mcer12/Nick-ESP8266/Media/truth_table_74141.jpg

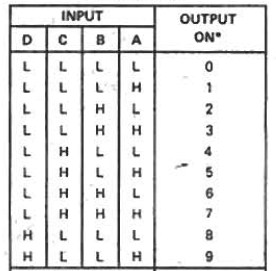
Media/truth_table_74141.jpg
