mcer12/Nick-ESP8266/Schematics + BOM/Schematic_NICK-IN16_DUPLEXED.png

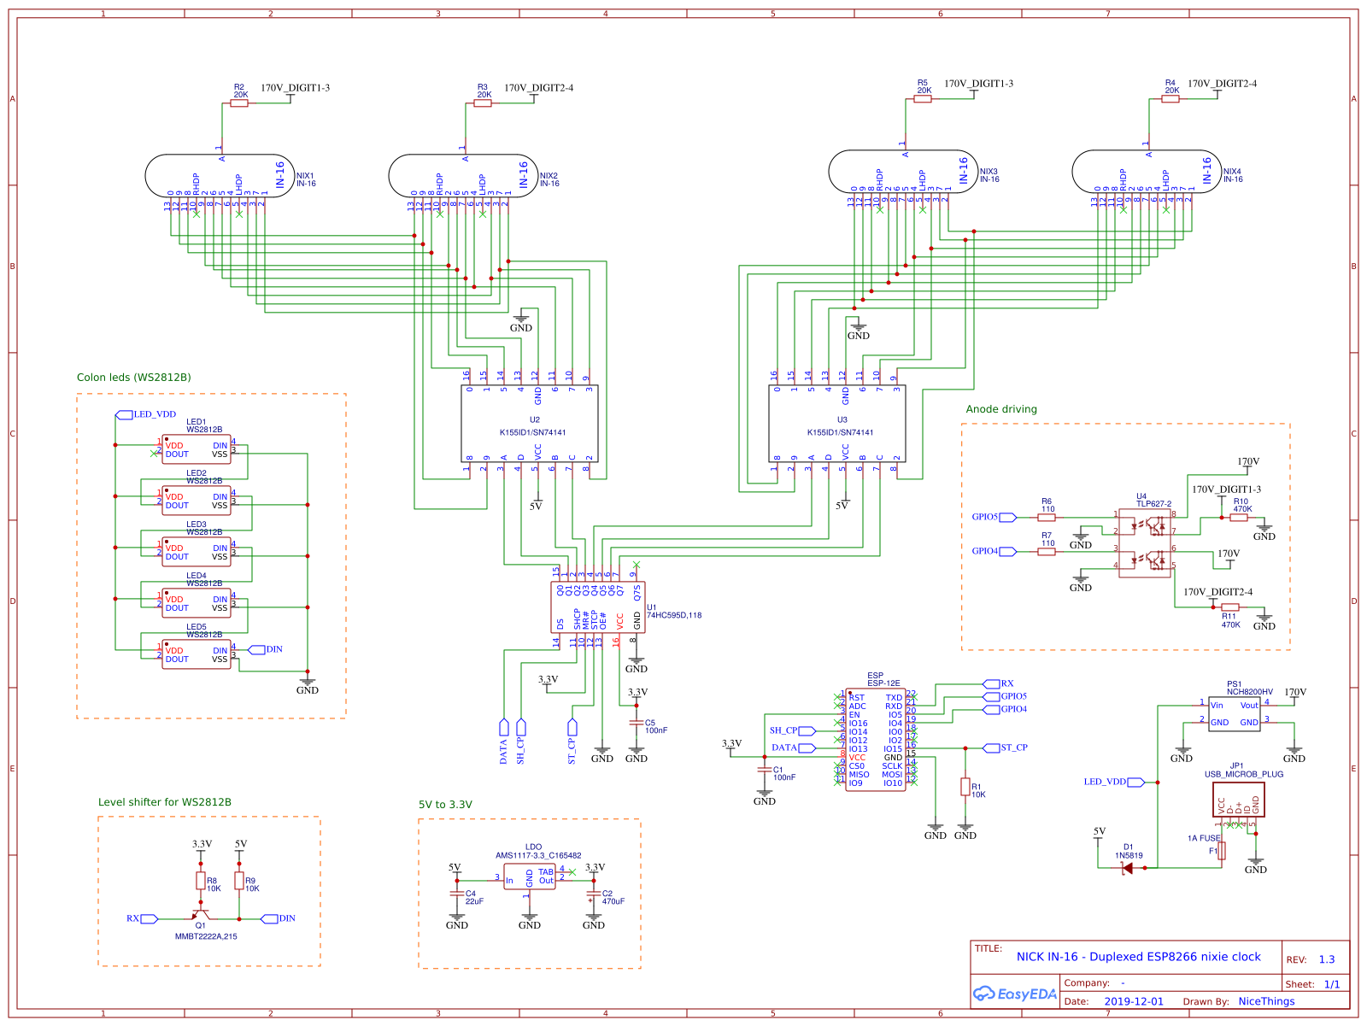
Schematics + BOM/Schematic_NICK-IN16_DUPLEXED.png
