mcer12/Nick-ESP8266/Schematics + BOM/NICK-IN12_BOM.csv

ID | Name | Designator | Footprint | Quantity | Manufacturer Part | Manufacturer | Supplier | Supplier Part | LCSC Assembly
1 | 10uF | C3 | CAP_0603 | 1 | TCC0603X5R106M160CT | CCTC | LCSC | C380317
2 | 330 | R6,R7 | R0603 | 2 | 0603WAJ0331T5E | UniOhm | LCSC | C25231
3 | K155ID1/SN74141 | U3,U4,U5,U6 | DIP16 | 4
4 | TLP627-2(F) | U8 | PDIP-8_L9.5-W6.6-P2.54-LS8.0-BL | 1 | TLP627-2(F) | TOSHIBA | LCSC | C845530
5 | MMBT2222A,215 | Q1 | SOT-23-3_L2.9-W1.6-P1.90-LS2.8-BR | 1 | MMBT2222A,215 | Nexperia | LCSC | C179396 | Yes
6 | 74HC595D,118 | U1,U2 | SOIC-16_150MIL | 2 | 74HC595D,118 | Nexperia | LCSC | C5947 | Yes
7 | U-D-M5DD-W-1 | USB1 | MICRO-USB-TH_MICRO-USB-A14 | 1 | U-D-M5DD-W-1 | HRO | LCSC | C145795
8 | 1A FUSE | F1 | FUSE_0805 | 1 | SMD0805P110TF | Yenji Elec | LCSC | C393933
9 | 100nF | C1,C4,C5 | 0603 | 3 | C0603C104K5RACTU | KEMET | LCSC | C127833
10 | WS2812B | LED1,LED2,LED3,LED4,LED5 | LED-5050_4P | 5 | WS2812B | Worldsemi | LCSC | C114585
11 | NCH8200HV | PS1 | NCH8200HV-1 | 1 | NCH8200HV
12 | 10K | R1,R8,R9 | RES_0603 | 3 | PTFR0603D10K0P9 | ResistorToday | LCSC | C375971
13 | 20K | R2,R3,R4,R5 | 1210 | 4 | RC1210JR-0720KL | YAGEO | LCSC | C276323
14 | AMS1117-3.3_C351784 | U7 | SOT-223-3_L6.5-W3.4-P2.30-LS7.0-BR | 1 | AMS1117-3.3 | PUOLOP | LCSC | C351784
15 | 470uF | C2 | CASE-D_7343 | 1 | TAJD477M006RNJ | AVX | LCSC | C106188 | Yes
16 | SW_IN-12B | NIX1,NIX2,NIX3,NIX4 | PK_IN-12B | 4
17 | 1N5819 | D1 | SOD-323_L1.8-W1.3-LS2.5-RD | 1 | 1N5819WS | KEXIN | LCSC | C369937
18 | ESP-12E | ESP | WIFIM-SMD_ESP-12E | 1 | ESP-12E | Ai-Thinker | LCSC | C89297
