mcer12/Nick-ESP8266/(threads)

Thread 1 (2021-01-23):

How do I choose my own NTP server?

tulpenwase, 2021-01-23:
Hallo mcer12,
first of all I must say the clock is the madness! Great work.
Now to my question, I would like to use my own NTP server in my network. All my devices on the network are already synchronized through it. Currently running on my router.  Is possible if so how do you do that exactly?

I have found in the IN12_DIRECT_NEW.ino the entry for the NTP server `const char* ntpServerName` there I would deposit the IP or NTP address of my router. So far so good. In the wiki you write that Arduino binary are supported. But how do I create a new firmeware that I can upload?

Or if I could wish something would be in an upcoming update a selection menu in the web interface very helpful.

mcer12, 2021-01-24:
Hi! The easiest thing to do would be to redirect all ntp requests to your
router. I have this option in my Asus router but you can probably do it in
other routers as well by hand.

Another way would be to change the ntp server in the sketch. You can use
option to export the binary in Arduino and then you upload it to the clock.
Be aware though that if there’s any issue in the sketch and it bricks the
clock, you will have to disassemble it to get to the serial breakout. Which
is quite annoying.

so 23. 1. 2021 v 22:06 odesílatel tulpenwase <notifications@github.com>
napsal:

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

tulpenwase, 2021-01-24:
Thank you very much for the answer. Unfortunately my router does not have this redirect function. So I have to either set up a new NTP server, for example on a Raspberry Pi, which can do this or I replace the sketch...i have no idea how difficult it will be.
In case I decide to use the new sketch I would be interested to understand how to do this exactly.
I edit the IN12_DIRECT_NEW.ino and export it as binary IN12_DIRECT_NEW.hex. The *.hex and only this one file I then upload under IP_ADRESS/update with Update Firmware? Then reboot and cross my fingers.
Oh, and is there anything to note about the libraries you used for the sketch? So certain versions or from whom it was offered. I had several problems in the past because I used the wrong one.

I see forward

mcer12, 2021-01-24:
No, in arduino IDE you can open tab Project / Export compiled binary. This will compile the project and save it as .bin file in the project directory. You still have to (!!!) set the ESP options to 1MB flash + 64KB FS, 160mhz frequency. If you forget to change the flash size, it will probably brick the clock. Sadly, I don't know what versions of libraries are used there as it's been a while since I flashed it. Hopefully downloading the latest versions will work fine.

I think it would be for the best if I just add the option in firmware and you just download the binary from github and upload it :) I will try to get to it at the start of the week.

tulpenwase, 2021-01-25:
Good evening, I'm glad you took the trouble to add the option. Thank you very much.

mcer12, 2021-01-31:
I've added the option and fixed a bug in daylight saving. I tested it on my clock and it works OK so fingers crossed :D It accepts server address or IP. You can use the binary in sketch directory.

tulpenwase, 2021-01-31:
Good evening,

I uploaded the binary today and it works beautifully. Immediately, after changing the NTP address detected my router and displayed the correct time. Thank you very much for the effort.

I hereby close the ticket.

Closed 2021-01-31.

Thread 5 (2021-10-02):

Schematic, BOM and gerber differences

Xundi007, 2021-10-02:
Hello,

I'm impressed by this project and wish to build this clock. The IN-12 direct drive variant.
But stuck at the BOM + shared gerbers and schematic differences.

There were some which I was able to guess it, but some of them I would like to ask for clarification, just to be sure.
These are my observations:
* The schematic shows HT7333 as LDO, where in the gerbers and BOM it is AMS1117. But with the 7333 cap values.
* The LDO capacitors marked on the schematic and BOM C2 and C3. But in the gerber silkscreen, the numbers are reversed, as C3 being the tantalum cap.
* The capacitor numbers on the gerber silkscreen generally seems to be shifted, for example on the schematic the ESP-VCC C1 cap appears to be the C4 on the gerbers.
Or the C4 and C5 caps on the schematic (on the VCC of the 74HC595Ds) are C5 and C6 on the PCB.
* And on the PCB, there is another C5 for the NCH8200HV.

I would like to ask for help on these:
* On the PCB silkscreen, the resistors R2,R3,R4,R5 are near the TLP627-2. On the schematic, near the TLP627 are just R6 and R7.
On the BOM, R2-R5 are the 20K 1210 anode resistors, which obviously not fit there on the PCB.
Which values would be good for R2,R3,R4,R5 near the TLP627-2?
* The BOM R6 and R7 are 330 Ohm values, on the schematic these are just 110.
* On the PCB silkscreen, on the nixie part, there is 8 resistor marking for the anode resistors. (R1,R2,blank,blank,R3,R4,R5,R6).
On the BOM and schematic, there are just 4x 20k 1210 piece. How should I populate them? 8*10k?
* On the schematic and BOM, there is a level shifter for the WS1812 leds, but on this PCB version, there is no such thing?
* On the backside of the nixie pcb, there are 5 unmarked smd slot near the leds. On the schematic these are not mentioned.
 I guess these for the decoupling capacitors? 100nF would be good?

Thanks in advance!
Best wishes,

mcer12, 2021-10-02:
Hi, sorry, for some reason there was an outdated shematic. I just pushed the correct schematic, please check it out. That said, this design is old and there are errors in component designators anyway.

I was BAD at easyeda back than and the pcb and schematic is kinda all over the place.

I will be doing a redesign in the upcoming weeks which will have everything properly set up, including BOM. If you didn't order the pcb yet, I would suggest to wait for the new version. You can maky my VFD clock in the meantime which is up to standards and well documented:
https://github.com/mcer12/Flora-ESP8266

Xundi007, 2021-10-02:
Thank you for the quick reply!
Well, I did ordered the pcbs, but if there will be a new, redesigned version of them I will wait for it, no problem. :)
Yes, I was planning about the Flora version too, just started with the nixies because I have some of them already on hand.
I will go on some shopping spree today for vfd. :)

And lastly, I would like to thank you for making these nice, clean designs for these tubes. With modern, available components. Complete with the 3D printed case too.

mcer12, 2021-10-02:
Regarding the differences between pcb and schematic:
| PCB | SCHEMATIC | SHOULD BE |
| ------------- | ------------- | ------------- |
| R5, R3 (near TLP627) | missing in schematic | can be ommited |
| R4, R2 (near TLP627) | R6, R7 | 200R-330R 0603 |
| C6 | C5 | 100nF 0603 |
| C5 | missing in schematic | can be ommited |
| C4  | C1  | 100nF 0603 |
| C1  | missign in schematic | can be ommited |
| C2, C3  | C3, C2 (switched) | |
| R1-R6 (top pcb) | R2-R5 | Resistors are split in two on PCB to easily combine resistance, 1206 package |

This should be all, but as I said, I would wait for the new version. The new version will have CH340 onboard for easy flashing via USB among other changes.

Xundi007, 2021-10-02:
Thank you again, for these additional comparison too! :)
I will probably wait for the new version.
Best wishes,

Closed 2021-10-03.

Thread 6 (2021-12-18):

WEMOS D1 MINI - Constantly rebooting

madebywitteveen, 2021-12-18:
Hi, mcer12
Trying to get the code working at an WEMOS D1 MINI without success unfortunately.
The WEMOS is constantly rebooting with an 1-second interval.

here is a brief serial monitor output:

ets_ Jan  8 2013,rst cause:2, boot mode:(3,6)

load 0x4010f000, len 3460, room 16
tail 4
chksum 0xcc
load 0x3fff20b8, len 40, room 4
tail 4
chksum 0xc9
csum 0xc9
v0006c9d0
~ld
[CONF] No credentials set, going to config mode.
START CONFIG-PORTAL
AT CONFIF_PORTAL
[SERV] IP address: 192.168.1.99
DNS-SERVER STARTED
MDNS STARTED

Somewhere in 'config_portal' I'm suspecting the problem to be.  Line 320 ??
Did some exception decoding and this was the result:

x4021f450: std::_Function_handler ::_M_invoke(std::_Any_data const&) at c:\users\whate\documents\arduinodata\packages\esp8266\tools\xtensa-lx106-elf-gcc\3.0.4-gcc10.3-1757bed\xtensa-lx106-elf\include\c++\10.3.0\bits/std_function.h line 289
0x4021f464: std::_Function_handler ::_M_manager(std::_Any_data&, std::_Any_data const&, std::_Manager_operation) at c:\users\whate\documents\arduinodata\packages\esp8266\tools\xtensa-lx106-elf-gcc\3.0.4-gcc10.3-1757bed\xtensa-lx106-elf\include\c++\10.3.0\bits/std_function.h line 268
0x40205dd8: handleNotFound() at C:\SynologyDrive\DOCS HENK\PROJECT\ESP8266 GITHUB NIXIE\Nick-ESP8266-master\IN16_DUPLEX_HW_SPI/config_portal.ino line 320
0x4021f464: std::_Function_handler ::_M_manager(std::_Any_data&, std::_Any_data const&, std::_Manager_operation) at c:\users\whate\documents\arduinodata\packages\esp8266\tools\xtensa-lx106-elf-gcc\3.0.4-gcc10.3-1757bed\xtensa-lx106-elf\include\c++\10.3.0\bits/std_function.h line 268
0x4021f450: std::_Function_handler ::_M_invoke(std::_Any_data const&) at c:\users\whate\documents\arduinodata\packages\esp8266\tools\xtensa-lx106-elf-gcc\3.0.4-gcc10.3-1757bed\xtensa-lx106-elf\include\c++\10.3.0\bits/std_function.h line 289
0x4021f4d0: std::_Function_handler  ::setup(esp8266webserver::ESP8266WebServerTemplate *, String const&, String const&, String const&)::{lambda()#3}>::_M_manager(std::_Any_data&, std::_Function_handler  ::setup(esp8266webserver::ESP8266WebServerTemplate *, String const&, String const&, String const&)::{lambda()#3}> const&, std::_Manager_operation) at c:\users\whate\documents\arduinodata\packages\esp8266\tools\xtensa-lx106-elf-gcc\3.0.4-gcc10.3-1757bed\xtensa-lx106-elf\include\c++\10.3.0\bits/std_function.h line 268
0x40203370: std::_Function_handler  ::setup(esp8266webserver::ESP8266WebServerTemplate *, String const&, String const&, String const&)::{lambda()#3}>::_M_invoke(std::_Any_data const&) at c:\users\whate\documents\arduinodata\packages\esp8266\tools\xtensa-lx106-elf-gcc\3.0.4-gcc10.3-1757bed\xtensa-lx106-elf\include\c++\10.3.0\bits/invoke.h line 103
0x40212c00: HardwareSerial::flush() at C:\Users\whate\Documents\ArduinoData\packages\esp8266\hardware\esp8266\3.0.2\cores\esp8266\HardwareSerial.cpp line 125
0x40214178: Print::println() at C:\Users\whate\Documents\ArduinoData\packages\esp8266\hardware\esp8266\3.0.2\cores\esp8266/Print.h line 57
0x40220035: fs::File::setTimeCallback(long long (*)()) at C:\Users\whate\Documents\ArduinoData\packages\esp8266\hardware\esp8266\3.0.2\cores\esp8266\FS.cpp line 208
0x4020aa13: setup() at C:\SynologyDrive\DOCS HENK\PROJECT\ESP8266 GITHUB NIXIE\Nick-ESP8266-master\IN16_DUPLEX_HW_SPI/IN16_DUPLEX_HW_SPI.ino line 293
0x40216878: loop_wrapper() at C:\Users\whate\Documents\ArduinoData\packages\esp8266\hardware\esp8266\3.0.2\cores\esp8266\core_esp8266_main.cpp line 198

Could you help me out ?

mcer12, 2021-12-18:
Hi, I suspect you're using the new ESP8266 arduino core which is not supported. You have to use 2.7.4

If you want to make it work with version 3.0+ I am happy to accept PR.

madebywitteveen, 2021-12-19:
Hi mcer12, reverted back the core and using 2.7.4
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

The IDE is currently set to 'LOLIN' (WEMOES)  D1 R2 & mini which should be correct ? Tried setting the board to 'Generic ESP8266' also without luck.
The Erase Flash setting in the IDE is set to 'All Flash Contents' but that didn't change a thing either.
Tried connecting to an external 5VDC lab supply instead of the USB cable but that didn't make any difference.
Any ideas ?

The hardware connected to the ESP (shift registers and so on) is similar to the setup I'm using but the code needs some change to make it work.
Can you please contact me via the contact form at my website.
Thankyou

mcer12, 2021-12-19:
Sorry, if you want me to help, you will have to use this github issue.

1. uninstall ESP8266 completely, then install it again (just to be sure)
2. copy modified SPI library from link below to your arduino libraries folder
https://github.com/mcer12/Flora-ESP8266/tree/main/Libraries/SPI
3. flash the firmware again with "erase all flash contents" selected

That SPI library is needed, I will make sure to note it somewhere in this repo wiki.

madebywitteveen, 2021-12-20:
Yes my man! The SPI library was the problem!
it is working now, thanks.
Is the IP-address (3 digits) after booting displayed at the tubes when having your hardware ?

About my hardware, I'm using an 20-output HV shift register (HV5812 by microchip) the six anodes are scanned in duo's.
Enable one : Hour-Digit1 & Minute-Digit2 are enabled at the same time
Enable two : Hour-Digit2 & Second-Digit1 are enabled at the same time
Enable three : Minute-Digit1 & Second-Digit2 are enabled at the same time
output's 1-10 are connected to digit's 1,2&3
output's 11-20 are connected to digit's 4,5&6

is this something you would change for me?
I do have some more requests please. I am willing to reward you

Thankyou

mcer12, 2021-12-21:
So you're saying you're using the sketch with totally different hardware? I can't help you with that, sorry.

The sketch is intended for SN74141 nixie driver, not for shift registers. You will have to rewrite the nixie driving functions to match your setup. I plan on making a new nixie clock with shift registers but don't know when I get to that.

madebywitteveen, 2021-12-21:
Thankyou Mcer,

In your hardware are two shift registers used (74HC595D) and behind those the high-voltage drivers. (SN74141)

The HV5812 is basically your two 74HC595D’s and the high-voltage part combined in one package.

The SPI-control is similar bit the bitstring (length) and perhaps the order needs some adjusting.

Correct me if I am wrong but I don’t think this is a big deal?! Could you think this over again please?

nice holidays and best wishes

Henk

Van: mcer12 ***@***.***>
Verzonden: dinsdag 21 december 2021 12:04
Aan: mcer12/Nick-ESP8266 ***@***.***>
CC: madebywitteveen ***@***.***>; Author ***@***.***>
Onderwerp: Re: [mcer12/Nick-ESP8266] WEMOS D1 MINI - Constantly rebooting (Issue #6)

So you're saying you're using the sketch with totally different hardware? I can't help you with that, sorry.

The sketch is intended for SN74141 nixie driver, not for shift registers. You will have to rewrite the nixie driving functions to match your setup. I plan on making a new nixie clock with shift registers but don't know when I get to that.

—
Reply to this email directly, view it on GitHub <https://github.com/mcer12/Nick-ESP8266/issues/6#issuecomment-998685136> , or unsubscribe <https://github.com/notifications/unsubscribe-auth/APEZVYSSNNCO7APIZKAP4PDUSBNJHANCNFSM5KK77X6Q> .
Triage notifications on the go with GitHub Mobile for iOS <https://apps.apple.com/app/apple-store/id1477376905?ct=notification-email&mt=8&pt=524675>  or Android <https://play.google.com/store/apps/details?id=com.github.android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> .
You are receiving this because you authored the thread.  <https://github.com/notifications/beacon/APEZVYSGIH3FRGURXA4IJJ3USBNJHA5CNFSM5KK77X62YY3PNVWWK3TUL52HS4DFVREXG43VMVBW63LNMVXHJKTDN5WW2ZLOORPWSZGOHODLTUA.gif> Message ID: ***@***.*** ***@***.***> >

Thread 7 (2022-04-09):

board audit failed onjlpcb

Tom-Neverwinter, 2022-04-09:
jlcpcb.com

> Thanks for submitting your files to review in JLCPCB. We regret to inform you that your order failed during the pre-production audit process. Reasons for the audit failure can be found in your order history. Thanks!

```
Audit failure reason:

the spacing from slot to slot and slot to board edge are too small which will cause the board broken easily,please kindly increase it to 4mm at least.
```

`Product Detail

Gerber file:
NICK-IN12_Gerber_Y5
Build Time:
3 daysBase Material:
FR-4
Layers:
2
Dimension:
99.8 mm* 71.92 mm
PCB Qty:
5
Different Design:
1
Delivery Fomat:
Single PCB
PCB Thickness:
1.6
Impedance:
no
Layer stackup:
PCB Color:
Black
Silkscreen:
White
Surface Finish:
LeadFree HASL-RoHS
Deburring/Edge rounding:
No
Outer Copper Weight:
1
Gold Fingers:
No
Flying Probe Test:
Fully Test
Castellated Holes:
no
Remove Order Number:
No
4-Wire Kelvin Test:
No
Material Type:
FR4-Standard Tg 130-140C
Paper between PCBs:
No
Appearance Quality:
IPC Class 2 Standard
Confirm Production file:
No`

mcer12, 2022-04-10:
Hi, this design is old and other users found discrepancies in bom. Check out my flora vfd clock which is much better designed and uses lcsc components so you can have it partially assembled. I am making new design with esp32 which will be properly done with lcsc components so I suggest to wait for that. It will be compatible with the same enclosure.

Tom-Neverwinter, 2022-04-12:
I will wait for the new board design ♥

Closed 2022-04-12.

Thread 8 (2022-07-22):

BOM & Gerber for IN16 duplexed variant

kafisc1, 2022-07-22:
Thank you very much for this great project. Could you pelase provide the BOM, Gerber and CPL (pickandplace) files for the IN16 duplexed variant? Would be great! I've already created the Flora-ESP8266 with IV-12 tubes and it came out incredible and I'm kind of addicted to nixie clocks now!
Thank you in advance
