mcer12/Nick-ESP8266/Schematics + BOM/NICK-IN12_Schematic.pdf

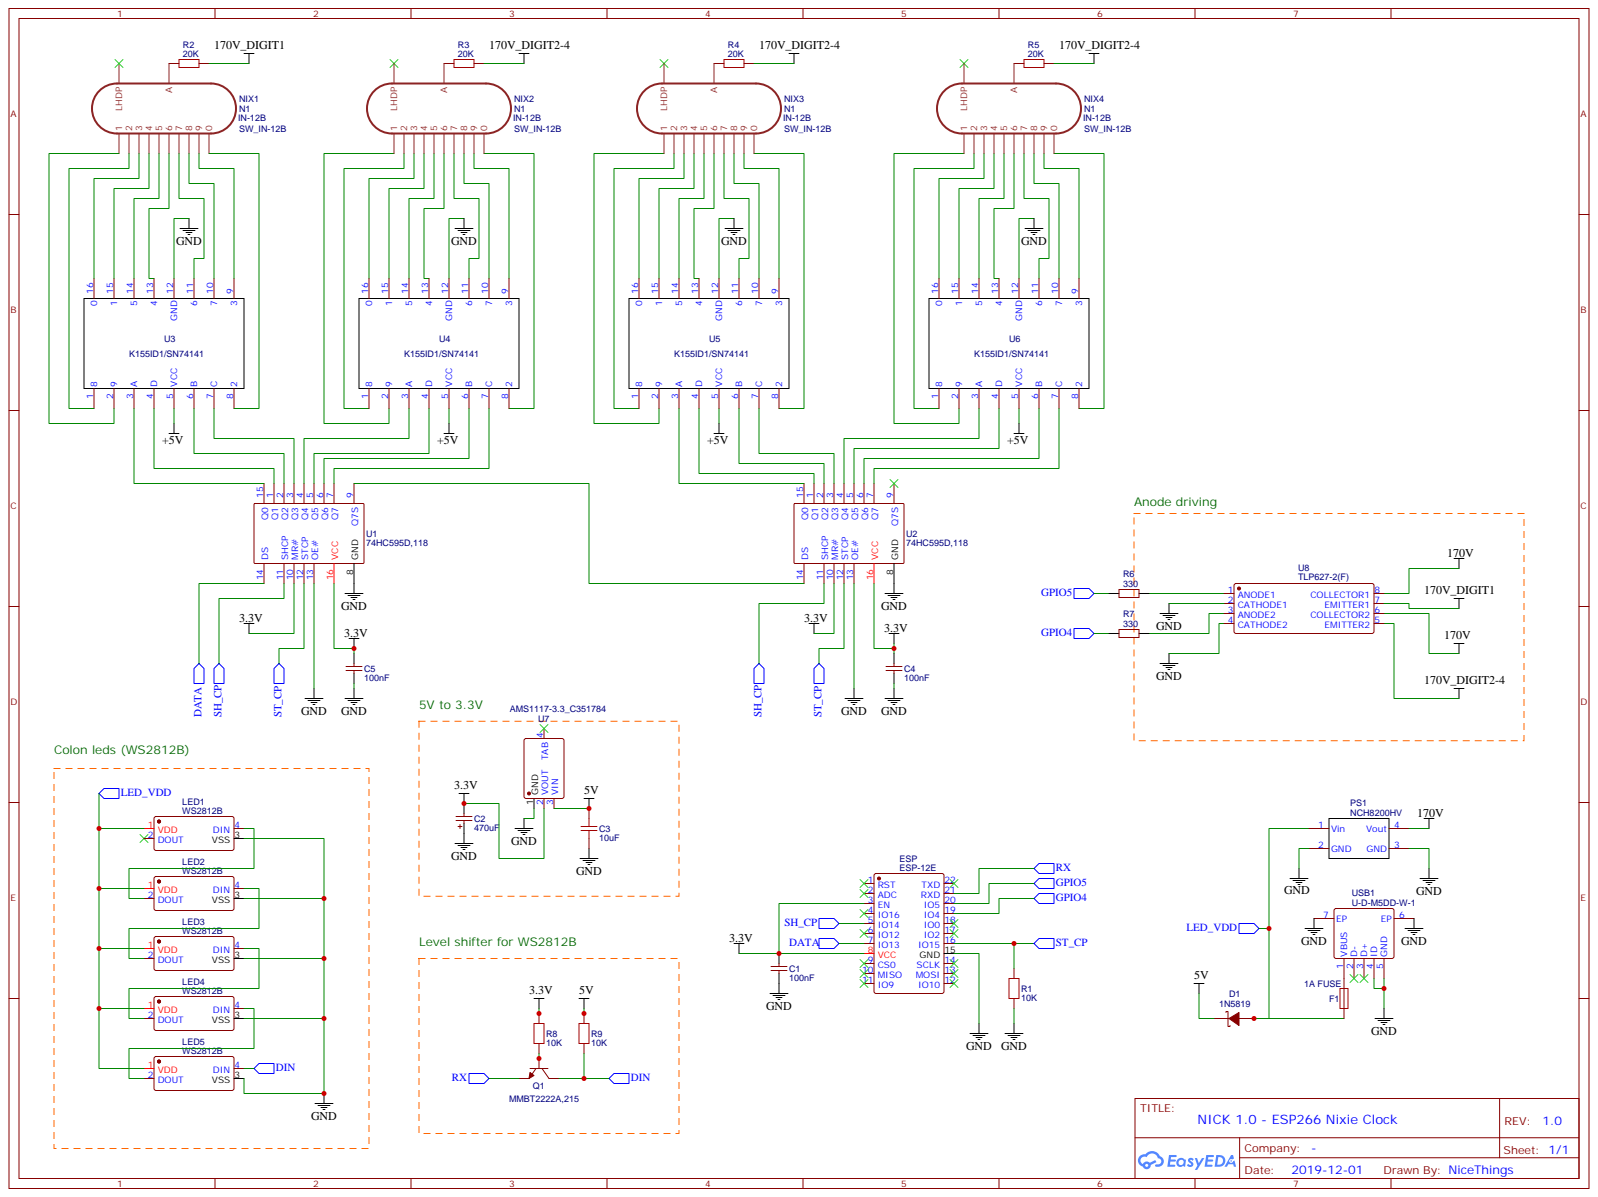
[picture p6: page 1]
