mcer12/Nick-ESP8266/(commit log)

2019-12-01 firmwares + schematic
2019-12-01 fixed schematics
2019-12-01 schematic edits
2020-11-23 Rewrite of firmware, custom config portal instead of wifi manager... added cathode poisoning prevention, brightness selection and complete timezone configuration
    [NDP_fns.ino, config_portal.ino, neopixel_fns.ino, nixies_fns.ino]
2021-01-31 added option for changing NTP provider, fixing daylight saving change
    [NDP_fns.ino, config_portal.ino]
2021-02-16 IN-12 gerber + BOM
    [NICK-IN12_BOM.csv]
2021-09-15 HW SPI update for the 4-digit IN16 duplexed clock
2021-10-02 schematic fix
